vikonix/O-Clock/docs/2020-03-30_223832.png

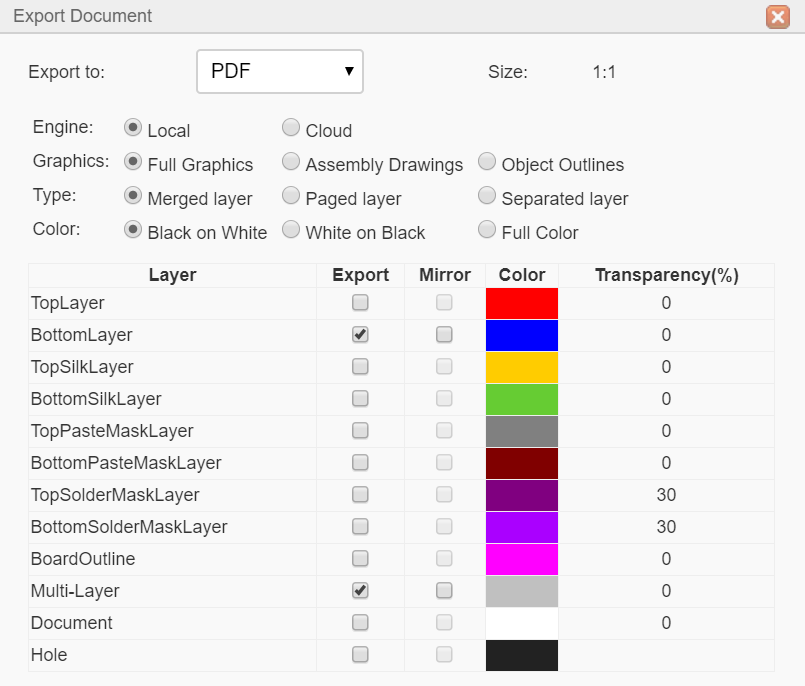
docs/2020-03-30_223832.png
