vikonix/O-Clock/docs/breadboard2.jpg

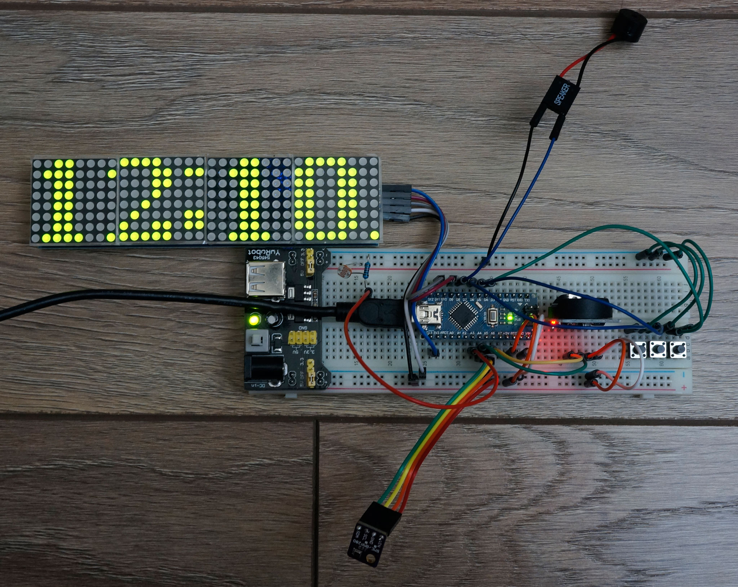
docs/breadboard2.jpg
