vikonix/O-Clock/docs/pcb layer.jpg

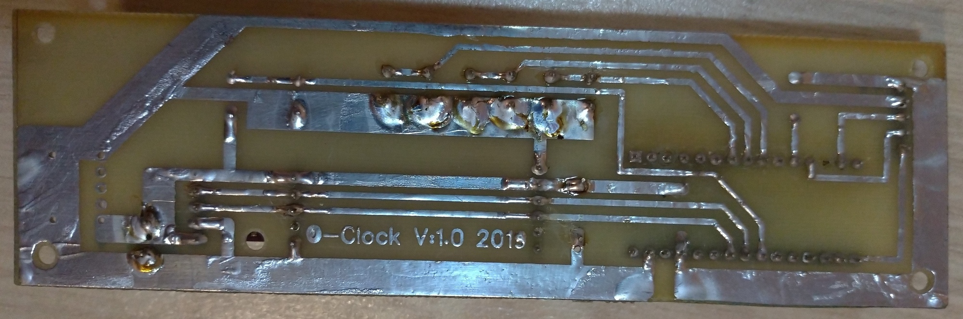
docs/pcb layer.jpg
