vikonix/O-Clock/docs/pcb components.jpg

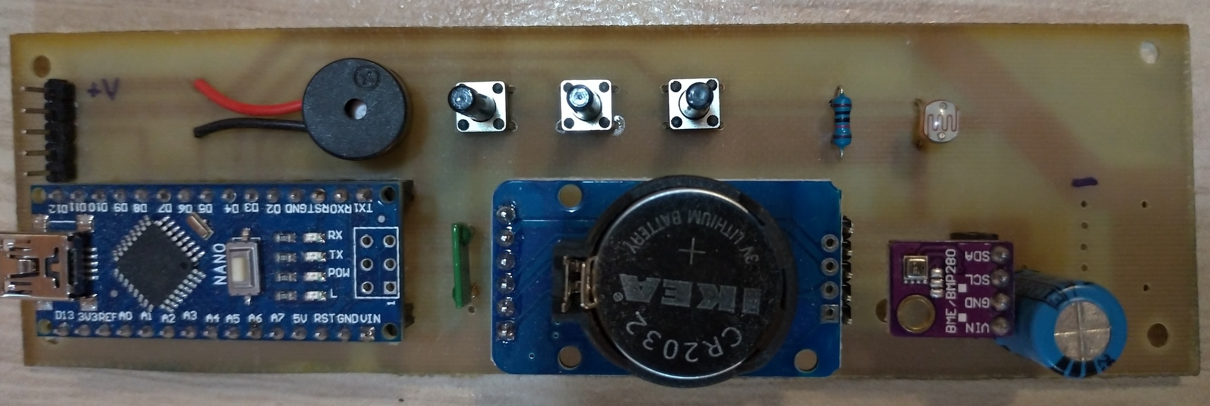
docs/pcb components.jpg
