vikonix/O-Clock/(threads)

Thread 1 (2020-08-18):

Font and wake up lights?

centaurclock, 2020-08-18:
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
Hi, I'd like to change the temp/pressure display so that it will display only temp or humidity, same size as the main font in the same place, I also want to add some LED lights to the alarm as a sunrise simulator, would this need to be 1 coming on after the other or could it go from low to high? Any help would be appreciated. Lee.

vikonix, 2020-08-23:
Hi Lee.
The idea with big digits for temp/pressure is clear for me. Only question can you draw in any graphic editor how does you see it? This is only digits or some additional sign?

About "sunrise" it's not clear. Is it means that you want to see some light effect during alarm? For example it's light changing from low to high and down?

Valeriy

centaurclock, 2020-08-25:
Hi Valeriy,
The sunrise function would be like a sunrise or dawn simulator alarm clock, where over half an hour a light on the clock would go from compleatly off (low) to full on (high) to mimic sunrise, I don't know if a single LED would work for that as they are not very good at very low power which is why I was wondering if it would need a bank of  perhaps 10 with one coming on every three minutes, they would not be part of the dot matrix display but perhaps seperate.
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

What I'm ultimatly trying to build is a sort of nixie lamp clock, but as I can't afford the real tubes I was going to use your clock as the base, box it into a wooden houseing and use some plastic tubes cut in half at the front to make it look like nixie tubes, which is why I can't use the smaller font as it won't match where the matrix will be vissible.
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

vikonix, 2020-08-29:
Hi Lee,
I have created "develop" branch for nixie emulation. I changed showing temp with big digits. Is it what you expected?

centaurclock, 2020-09-04:
Thanks, thats made it show now. I was hoping to split the data, so at 15s it show temp and 45 it shows humidity, I don't know if thats possible with the BME280 sensor is it? or does the data come together so it can't be seperated?

vikonix, 2020-09-05:
It's not problem to separate them. What also you want to see at 30s ?

centaurclock, 2020-09-06:
Probably nothing, although I've been running it with them together and kinda like it like that as I can see both at the same time. I changed the seperator for those to a solid line so its clear its not the normal time display at a glance. Where are the melody files? are they in one of the libararies? I was trying to find them to take a look at adding a diferent sound and assumed they were actualy in the code in binary or something but I cant find them at the moment?

vikonix, 2020-09-07:
Melody you can see in oclock.cpp:96
// alarm melody in RTTTL format
You can find them with "nokia ringtone rtttl"

vikonix, 2020-09-07:
https://en.wikipedia.org/wiki/Ring_Tone_Transfer_Language

centaurclock, 2020-09-08:
ah, thankyou.

centaurclock, 2020-09-08:
Sorry to keep bothering you, I've got the buzzing you said about, do you have a diagram of where the capacitors go? I'm not sure where I'm supposed to add them in.
Kindest regards,
Lee.

vikonix, 2020-09-13:
I add simple power filter chematic
https://github.com/vikonix/O-Clock/blob/master/docs/Schematic_power%20filter_2020-09-13_20-39-50.pdf

centaurclock, 2020-09-15:
Thanks, that make it clear now.

centaurclock, 2020-09-25:
Thanks, I added the power filter in but still got some hiss, but I solved it by adding an LED parralel to the buzzer.

ooomakon, 2020-12-15:
Здравствуйте,а как можно сделать отображение давления в мм.рт?Спасибо.

vikonix, 2020-12-15:
Добрый вечер.

main.cpp:41
//#define PRESSURE_IN_MM

нужно раскомментировать эту строчку

ooomakon, 2020-12-15:
сделал, также осталось

vikonix, 2020-12-20:
Сейчас только что проверил. Нормально показывает в мм.

Closed 2021-09-04.
