vikonix/O-Clock/docs/Schematic_power filter_2020-09-13_20-39-50.pdf

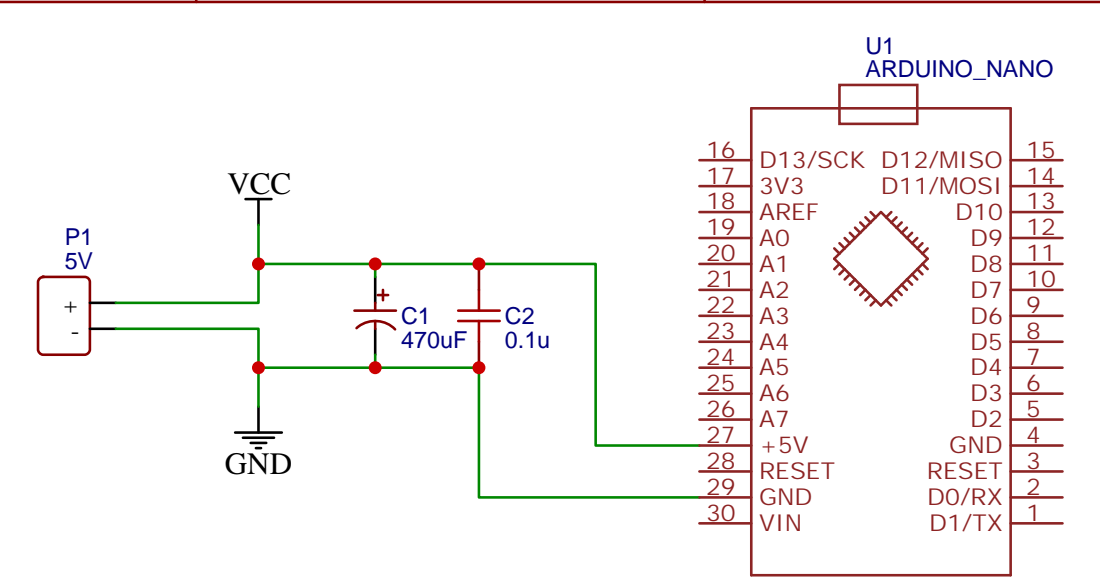
[picture p7: page 1]
