vikonix/O-Clock/docs/PCB_pcb2_20200330223437.pdf

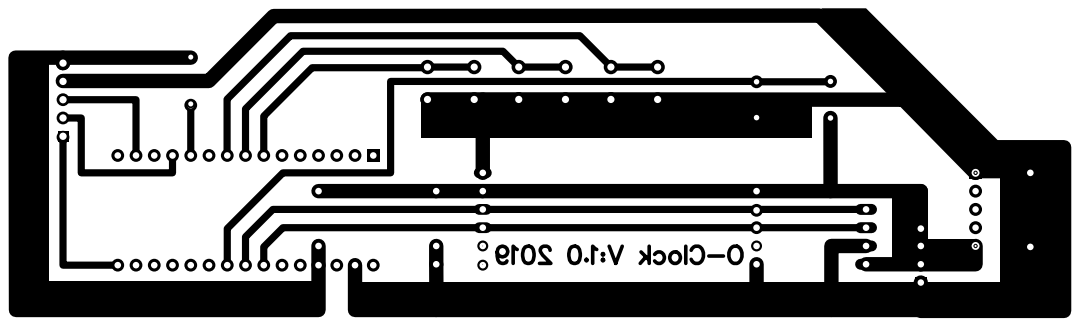
[picture p8: page 1]
