vikonix/O-Clock/(commit log)

2019-05-20 fix menu add pictures
    [main.cpp, oclock.cpp, src.ino]
2019-05-20 Add schematic
2019-05-22 fix bug with alarm day calculating add screen scroll for mode timeout
    [alarm.h, main.cpp]
2019-05-22 add temperature & date automatic show
2019-06-04 fix cursor position one more
    [main.cpp, oclock.h]
2019-11-17 Add pressure displaying
2019-11-17 Add PCB link
2019-11-28 switch off LED in full dark
2020-03-30 - add EasyEDA export options - add PCB mask for ironing
2020-03-30 add PCB photo
2020-06-10 Update libraries Add delay in automatic key repeat mode Add show pressure in mm Hg Increment version
2020-07-25 Add SWITCH_MODE_PERIOD for changing showing period of the Pressure/Temp/Date
2020-09-13 add the power filter schematic
2021-09-14 fix build for new version of Bounce2 library
    [main.cpp]
